stanford-ssi/Aerolotl_AB/aerolotl_ab.kicad_pcb

## KiCad design aerolotl_ab.kicad_pcb (2026-11-02)

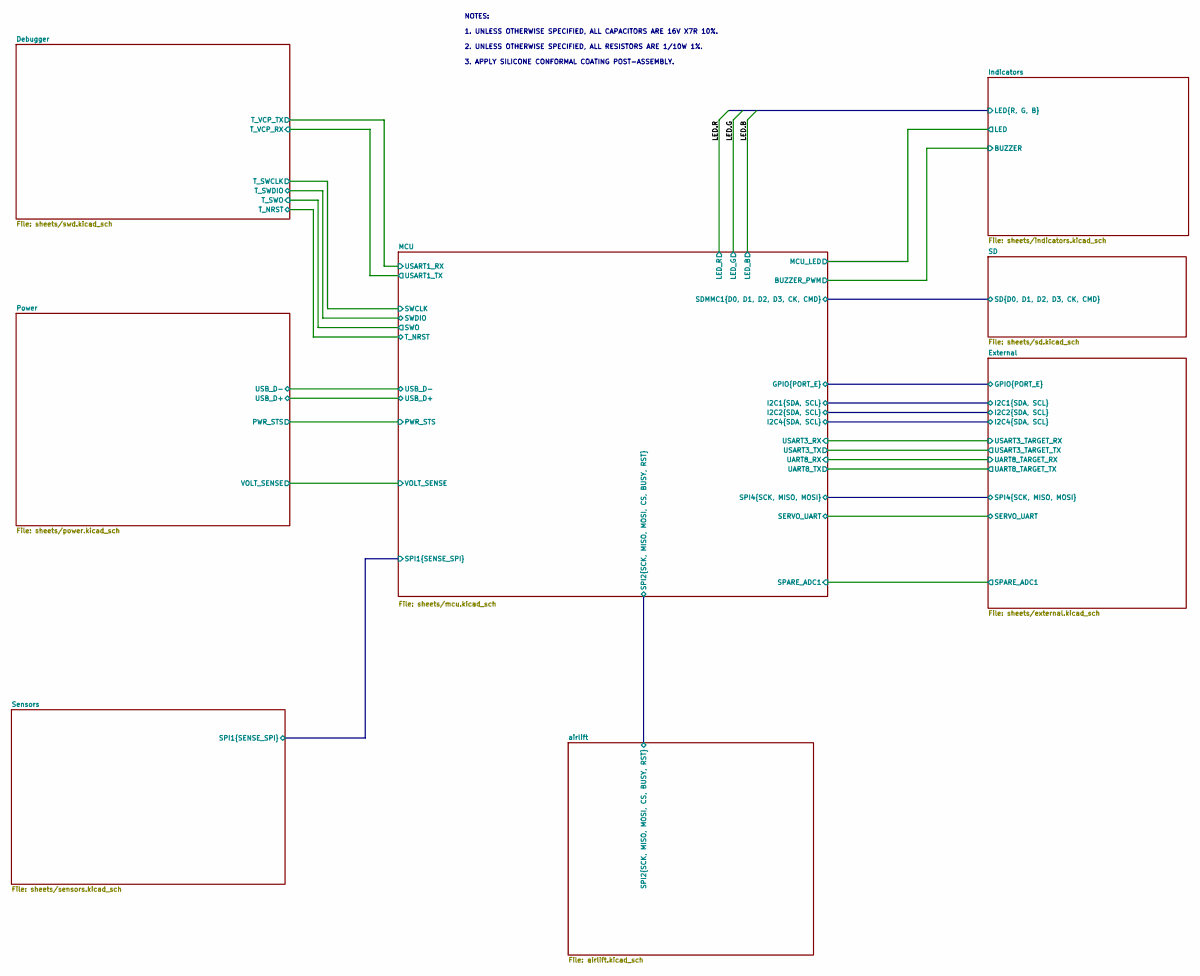
[picture p1: schematic aerolotl_ab.kicad_sch, AEROLOTL AIRBRAKES CONTROLLER]

Notes on the sheet:
NOTES: 1. UNLESS OTHERWISE SPECIFIED, ALL CAPACITORS ARE 16V X7R 10%. 2. UNLESS OTHERWISE SPECIFIED, ALL RESISTORS ARE 1/10W 1%. 3. APPLY SILICONE CONFORMAL COATING POST-ASSEMBLY.

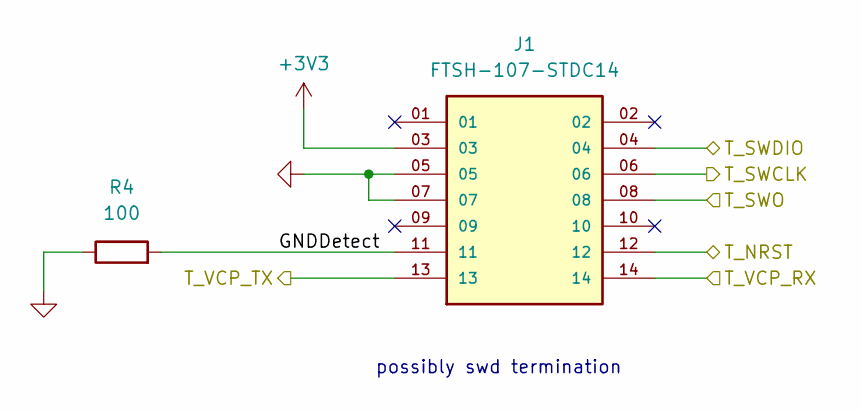
[picture p2: schematic swd.kicad_sch]

Parts:
J1: FTSH-107-STDC14; STDC14_SAMTEC_FTSH-107-01-L-DV-K-A; PARTREV H
R4: 100; R_0402_1005Metric

Connections:
+3V3: J1.03; also elsewhere on the board
/Debugger/GNDDetect: J1.11, R4.2
/Debugger/T_NRST: J1.12; also elsewhere on the board
/Debugger/T_SWCLK: J1.06; also elsewhere on the board
/Debugger/T_SWDIO: J1.04; also elsewhere on the board
/Debugger/T_SWO: J1.08; also elsewhere on the board
/Debugger/T_VCP_RX: J1.14; also elsewhere on the board
/Debugger/T_VCP_TX: J1.13; also elsewhere on the board
GND: J1.05, J1.07, R4.1; also elsewhere on the board

Notes on the sheet:
possibly swd termination

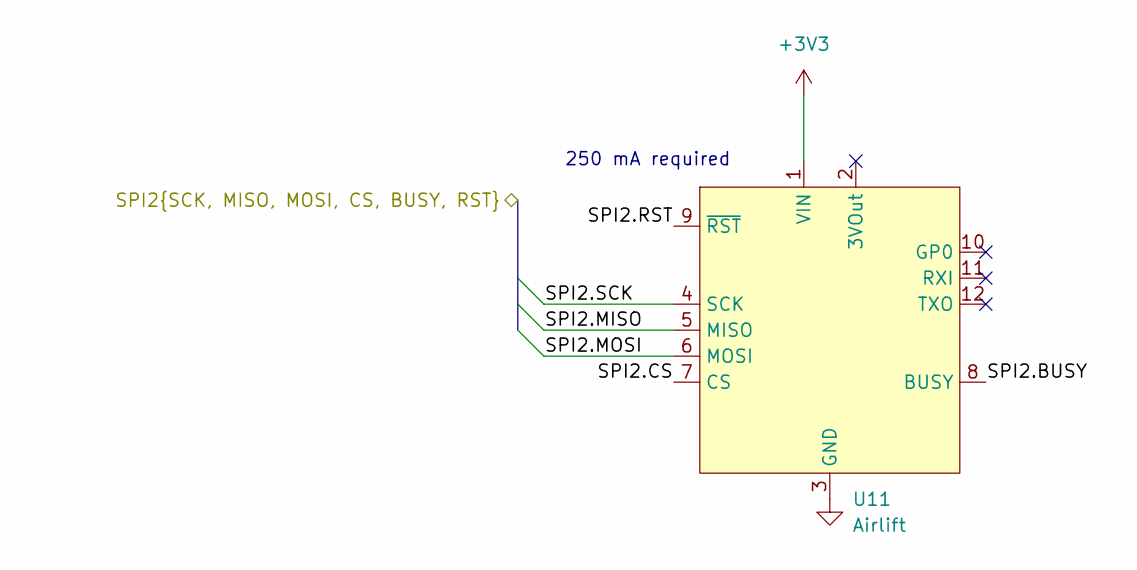
[picture p3: schematic airlift.kicad_sch]

Parts:
U11: Airlift; PinSocket_1x12_P2.54mm_Vertical; Mfr. Part No. 4201

Connections:
+3V3: U11.1 (VIN); also elsewhere on the board
/MCU/SPI2.BUSY: U11.8 (BUSY); also elsewhere on the board
/MCU/SPI2.CS: U11.7 (CS); also elsewhere on the board
/MCU/SPI2.MISO: U11.5 (MISO); also elsewhere on the board
/MCU/SPI2.MOSI: U11.6 (MOSI); also elsewhere on the board
/MCU/SPI2.RST: U11.9 (~RST); also elsewhere on the board
/MCU/SPI2.SCK: U11.4 (SCK); also elsewhere on the board
GND: U11.3 (GND); also elsewhere on the board

Notes on the sheet:
250 mA required

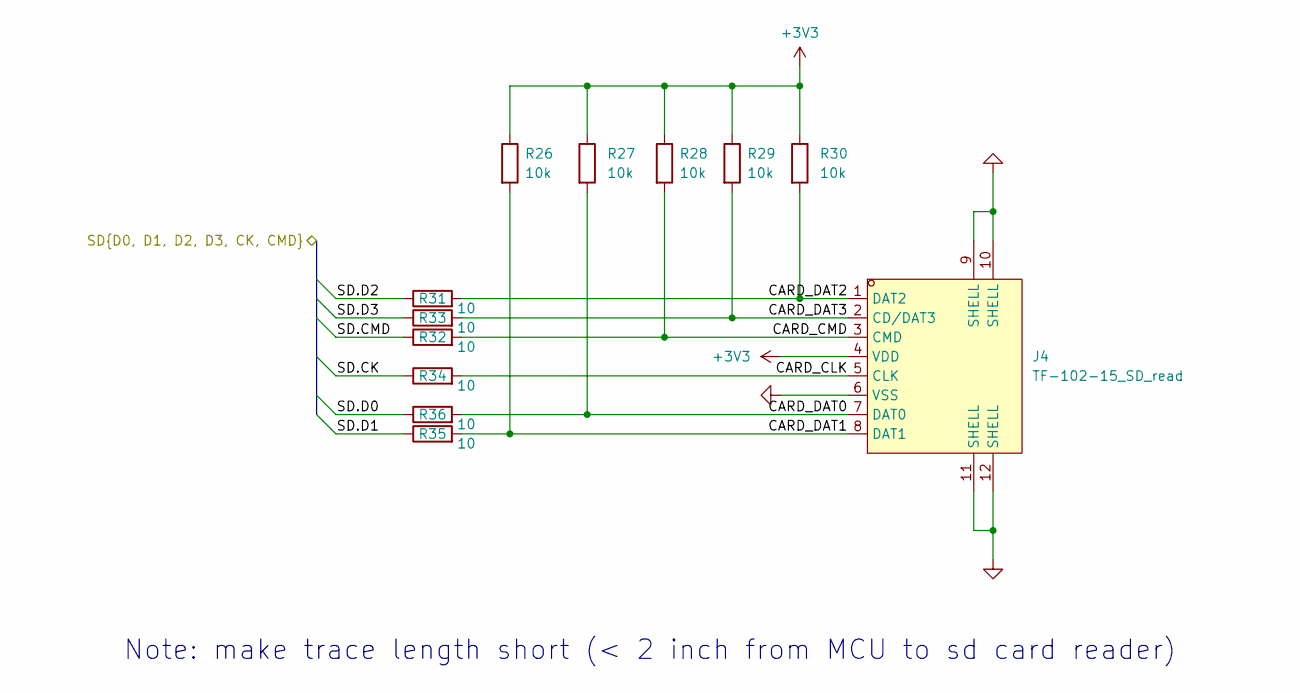
[picture p4: schematic sd.kicad_sch]

Parts:
J4: TF-102-15_SD_read; TF-SMD_TF-102-15; LCSC Part C266609
R26, R27, R28, R29, R30: 10k; R_0402_1005Metric; LCSC Part C25744
R31, R32, R33, R34, R35, R36: 10; R_0402_1005Metric

Connections:
+3V3: J4.4 (VDD), R26.1, R27.1, R28.1, R29.1, R30.1; also elsewhere on the board
/MCU/SDMMC1.CK: R34.1; also elsewhere on the board
/MCU/SDMMC1.CMD: R32.1; also elsewhere on the board
/MCU/SDMMC1.D0: R36.1; also elsewhere on the board
/MCU/SDMMC1.D1: R35.1; also elsewhere on the board
/MCU/SDMMC1.D2: R31.1; also elsewhere on the board
/MCU/SDMMC1.D3: R33.1; also elsewhere on the board
/SD/CARD_CLK: J4.5 (CLK), R34.2
/SD/CARD_CMD: J4.3 (CMD), R28.2, R32.2
/SD/CARD_DAT0: J4.7 (DAT0), R27.2, R36.2
/SD/CARD_DAT1: J4.8 (DAT1), R26.2, R35.2
/SD/CARD_DAT2: J4.1 (DAT2), R30.2, R31.2
/SD/CARD_DAT3: J4.2 (CD/DAT3), R29.2, R33.2
GND: J4.6 (VSS), J4.9 (SHELL), J4.10 (SHELL), J4.11 (SHELL), J4.12 (SHELL); also elsewhere on the board

Notes on the sheet:
Note: make trace length short (< 2 inch from MCU to sd card reader)

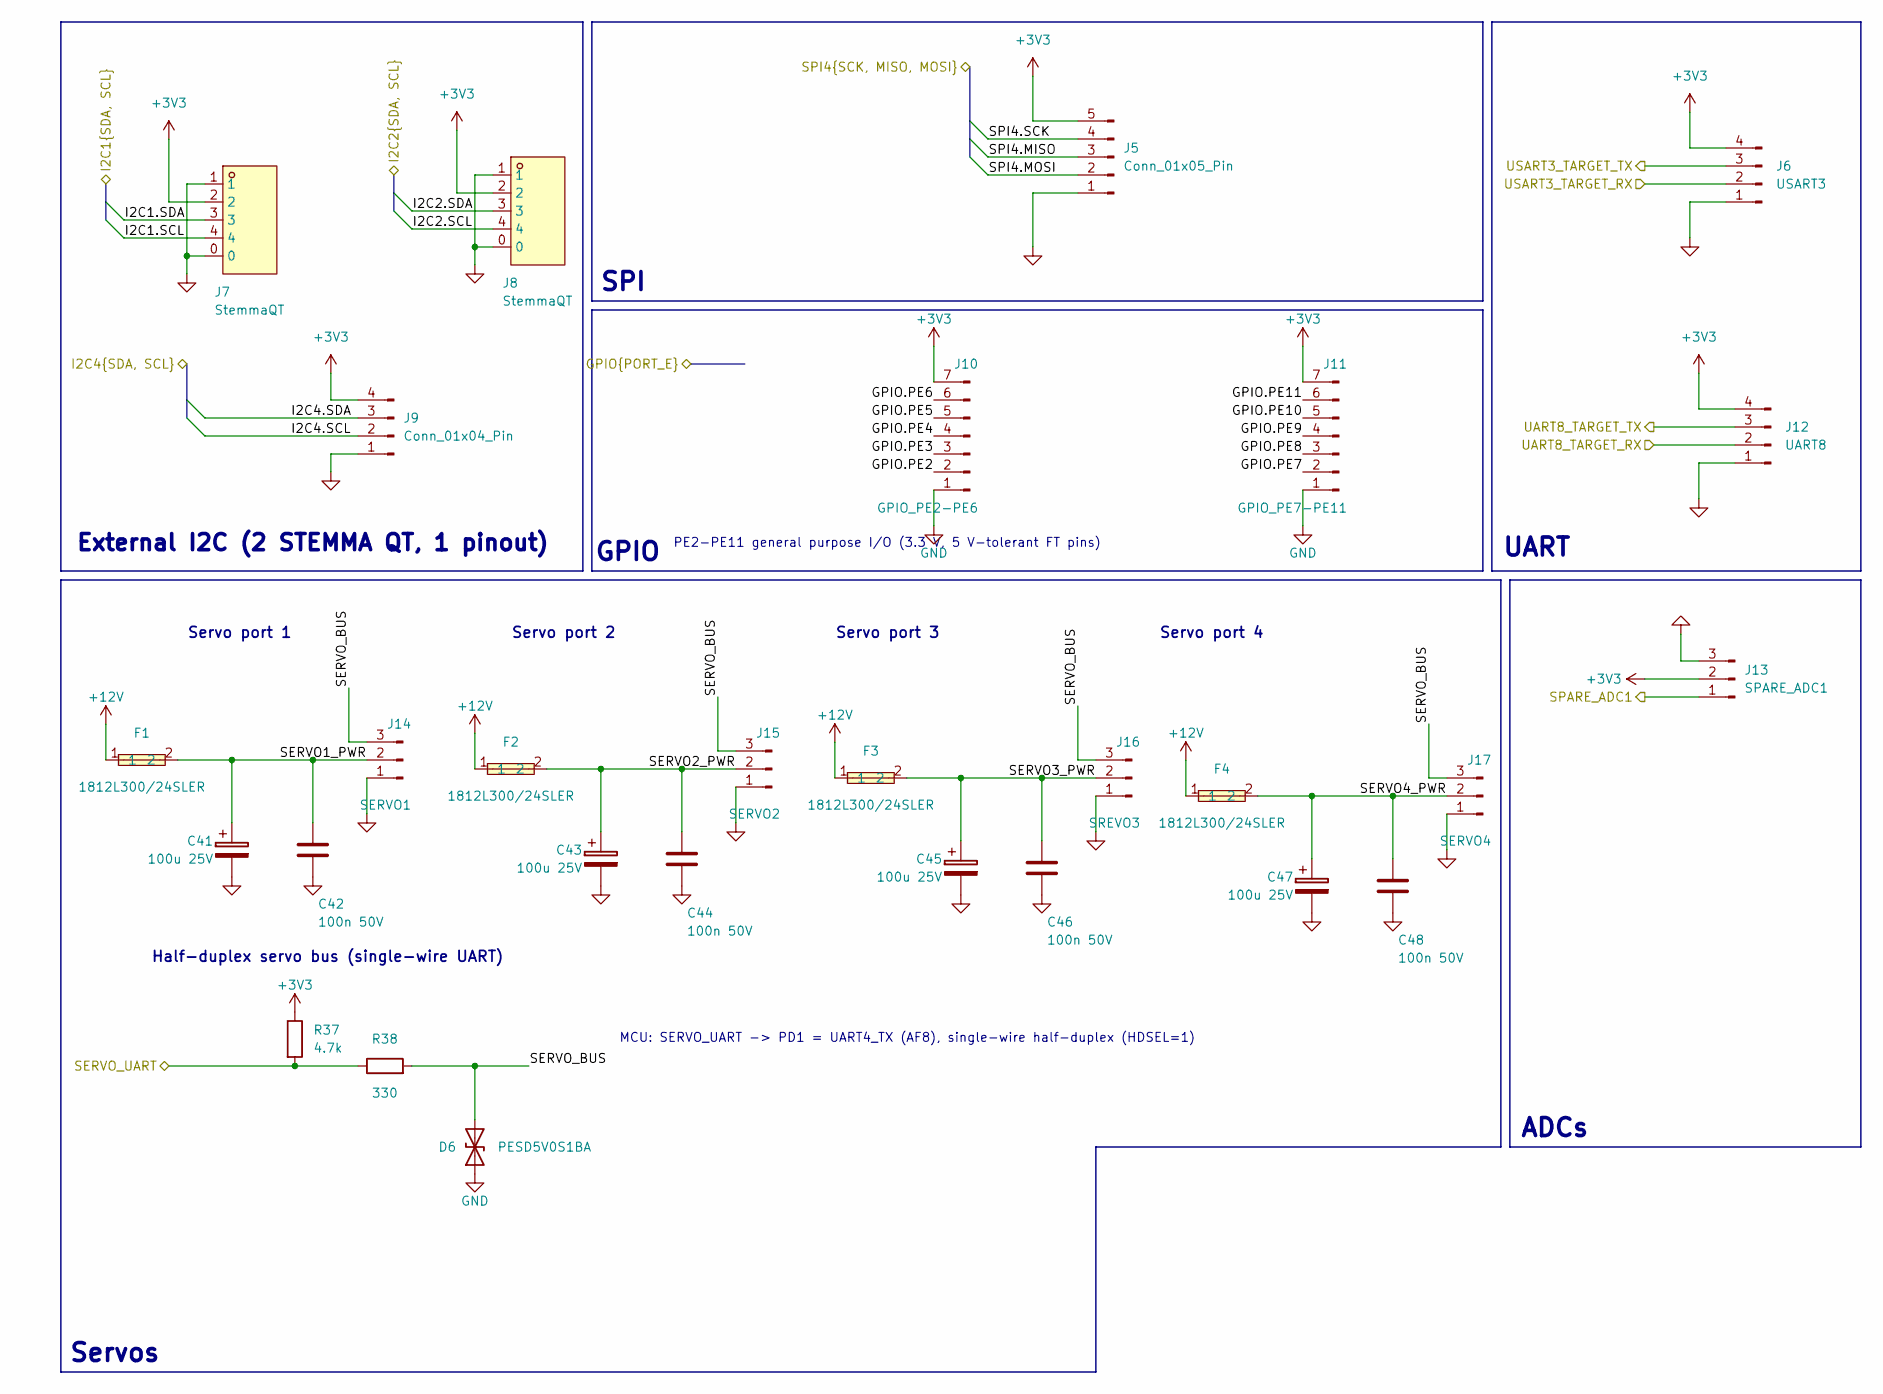
[picture p5: schematic external.kicad_sch]

Parts:
C41, C43, C45, C47: 100u 25V; CP_Elec_6.3x7.7
C42, C44, C46, C48: 100n 50V; C_0603_1608Metric
D6: PESD5V0S1BA; D_SOD-323
F1, F2, F3, F4: 1812L300/24SLER; Fuse_1812_4532Metric; LCSC Part C1512049
J5: Conn_01x05_Pin; JST_GH_BM05B-GHS-TBT_1x05-1MP_P1.25mm_Vertical
J6: USART3; JST_GH_BM04B-GHS-TBT_1x04-1MP_P1.25mm_Vertical
J7, J8: StemmaQT; LCSC Part C160390
J9: Conn_01x04_Pin; JST_GH_BM04B-GHS-TBT_1x04-1MP_P1.25mm_Vertical
J10: GPIO_PE2-PE6; JST_GH_BM07B-GHS-TBT_1x07-1MP_P1.25mm_Vertical; MPN SM07B-GHS-TB
J11: GPIO_PE7-PE11; JST_GH_BM07B-GHS-TBT_1x07-1MP_P1.25mm_Vertical; MPN SM07B-GHS-TB
J12: UART8; JST_GH_BM04B-GHS-TBT_1x04-1MP_P1.25mm_Vertical
J13: SPARE_ADC1; JST_GH_BM03B-GHS-TBT_1x03-1MP_P1.25mm_Vertical
J14: SERVO1; Molex_SPOX_5267-03A_1x03_P2.50mm_Vertical; MPN 5267-03A
J15: SERVO2; Molex_SPOX_5267-03A_1x03_P2.50mm_Vertical; MPN 5267-03A
J16: SREVO3; Molex_SPOX_5267-03A_1x03_P2.50mm_Vertical; MPN 5267-03A
J17: SERVO4; Molex_SPOX_5267-03A_1x03_P2.50mm_Vertical; MPN 5267-03A
R37: 4.7k; R_0402_1005Metric
R38: 330; R_0402_1005Metric

Connections:
+3V3: J5.5, J6.4, J7.2, J8.2, J9.4, J10.7, J11.7, J12.4, J13.2, R37.1; also elsewhere on the board
+12V: F1.1, F2.1, F3.1, F4.1; also elsewhere on the board
/External/GPIO.PE2: J10.2; also elsewhere on the board
/External/GPIO.PE3: J10.3; also elsewhere on the board
/External/GPIO.PE4: J10.4; also elsewhere on the board
/External/GPIO.PE5: J10.5; also elsewhere on the board
/External/GPIO.PE6: J10.6; also elsewhere on the board
/External/GPIO.PE7: J11.2; also elsewhere on the board
/External/GPIO.PE8: J11.3; also elsewhere on the board
/External/GPIO.PE9: J11.4; also elsewhere on the board
/External/GPIO.PE10: J11.5; also elsewhere on the board
/External/GPIO.PE11: J11.6; also elsewhere on the board
/External/I2C1.SCL: J7.4; also elsewhere on the board
/External/I2C1.SDA: J7.3; also elsewhere on the board
/External/I2C2.SCL: J8.4; also elsewhere on the board
/External/I2C2.SDA: J8.3; also elsewhere on the board
/External/I2C4.SCL: J9.2; also elsewhere on the board
/External/I2C4.SDA: J9.3; also elsewhere on the board
/External/SERVO1_PWR: C41.1, C42.1, F1.2, J14.2
/External/SERVO2_PWR: C43.1, C44.1, F2.2, J15.2
/External/SERVO3_PWR: C45.1, C46.1, F3.2, J16.2
/External/SERVO4_PWR: C47.1, C48.1, F4.2, J17.2
/External/SERVO_BUS: D6.2 (A2), J14.3, J15.3, J16.3, J17.3, R38.2
/External/SERVO_UART: R37.2, R38.1; also elsewhere on the board
/External/SPARE_ADC1: J13.1; also elsewhere on the board
/External/SPI4.MISO: J5.3; also elsewhere on the board
/External/SPI4.MOSI: J5.2; also elsewhere on the board
/External/SPI4.SCK: J5.4; also elsewhere on the board
/External/UART8_TARGET_RX: J12.2; also elsewhere on the board
/External/UART8_TARGET_TX: J12.3; also elsewhere on the board
/External/USART3_TARGET_RX: J6.2; also elsewhere on the board
/External/USART3_TARGET_TX: J6.3; also elsewhere on the board
GND: C41.2, C42.2, C43.2, C44.2, C45.2, C46.2, C47.2, C48.2, D6.1 (A1), J5.1, J6.1, J7.0, J7.1, J8.0, J8.1, J9.1, J10.1, J11.1, J12.1, J13.3, J14.1, J15.1, J16.1, J17.1; also elsewhere on the board

Notes on the sheet:
Servo port 1
External I2C (2 STEMMA QT, 1 pinout)
SPI
PE2-PE11 general purpose I/O (3.3 V, 5 V-tolerant FT pins)
Servo port 2
GPIO
Half-duplex servo bus (single-wire UART)
Servo port 4
UART
MCU: SERVO_UART -> PD1 = UART4_TX (AF8), single-wire half-duplex (HDSEL=1)
Servo port 3
Servos
ADCs

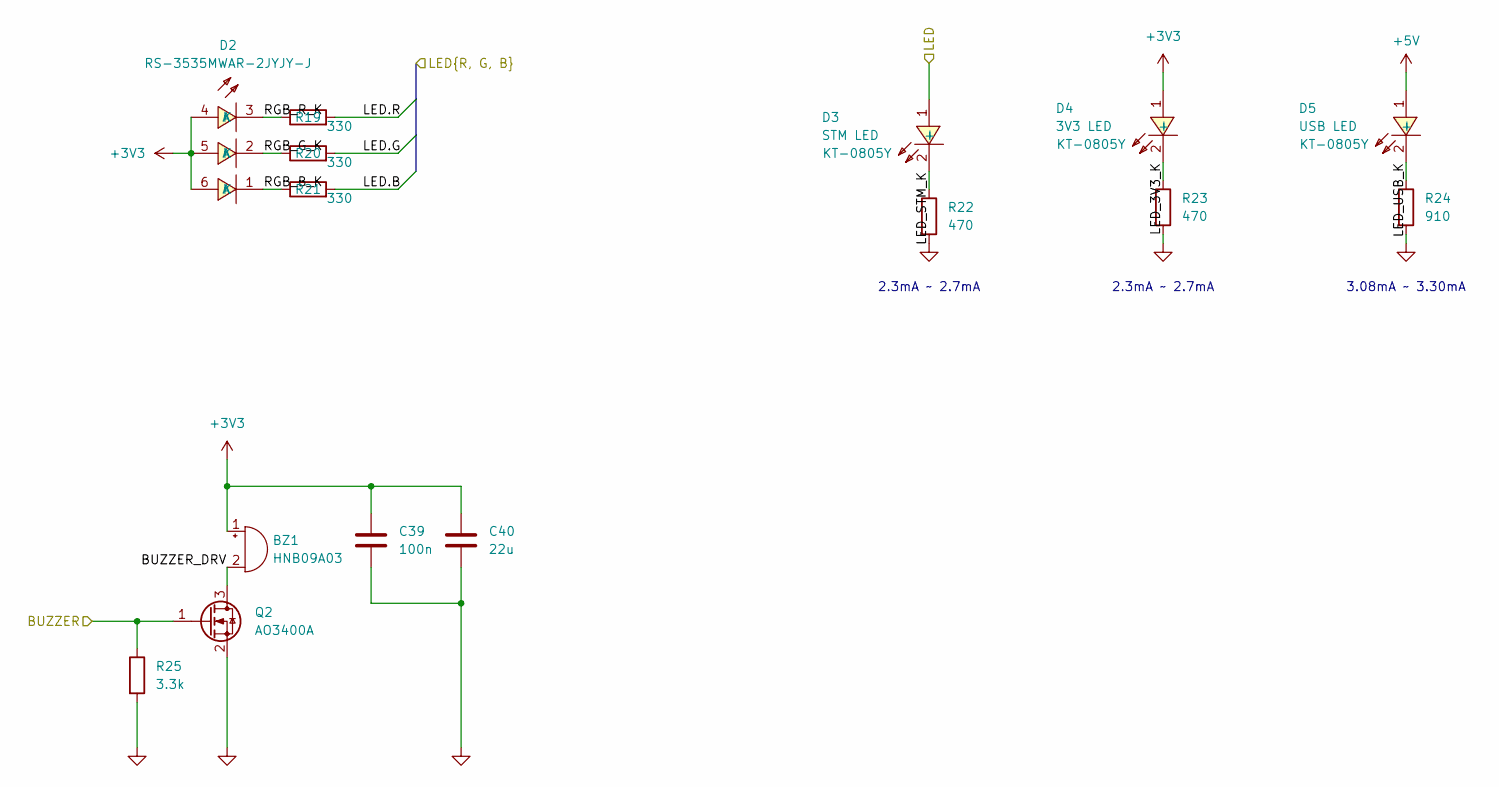
[picture p6: schematic indicators.kicad_sch, AEROLOTL NEW COLLINS FLIGHT COMPUTER]

Parts:
BZ1: HNB09A03; BUZ-TH_BD9.0-P5.00-D0.6-FD
C39: 100n; C_0402_1005Metric; LCSC Part C1525
C40: 22u; C_0805_2012Metric; LCSC Part C45783
D2: RS-3535MWAR-2JYJY-J; LED-SMD_RS-3535MWAR-2JYJY-J; MPN RS-3535MWAR; LCSC Part C110402
D3: STM LED; LED0805-R-RD; LCSC Part C2296
D4: 3V3 LED; LED0805-R-RD; LCSC Part C2296
D5: USB LED; LED0805-R-RD; LCSC Part C2296
Q2: AO3400A; SOT-23
R19, R20, R21: 330; R_0402_1005Metric
R22, R23: 470; R_0402_1005Metric
R24: 910; R_0402_1005Metric
R25: 3.3k; R_0402_1005Metric

Connections:
+3V3: BZ1.1 (+), C39.1, C40.1, D2.4 (A), D2.5 (A), D2.6 (A), D4.1 (+); also elsewhere on the board
+5V: D5.1 (+); also elsewhere on the board
/Indicators/BUZZER: Q2.1 (G), R25.1; also elsewhere on the board
/Indicators/BUZZER_DRV: BZ1.2 (-), Q2.3 (D)
/Indicators/LED: D3.1 (+); also elsewhere on the board
/Indicators/LED.B: R21.2; also elsewhere on the board
/Indicators/LED.G: R20.2; also elsewhere on the board
/Indicators/LED.R: R19.2; also elsewhere on the board
/Indicators/LED_3V3_K: D4.2 (-), R23.1
/Indicators/LED_STM_K: D3.2 (-), R22.1
/Indicators/LED_USB_K: D5.2 (-), R24.1
/Indicators/RGB_B_K: D2.1 (K), R21.1
/Indicators/RGB_G_K: D2.2 (K), R20.1
/Indicators/RGB_R_K: D2.3 (K), R19.1
GND: C39.2, C40.2, Q2.2 (S), R22.2, R23.2, R24.2, R25.2; also elsewhere on the board

Notes on the sheet:
2.3mA ~ 2.7mA
3.08mA ~ 3.30mA

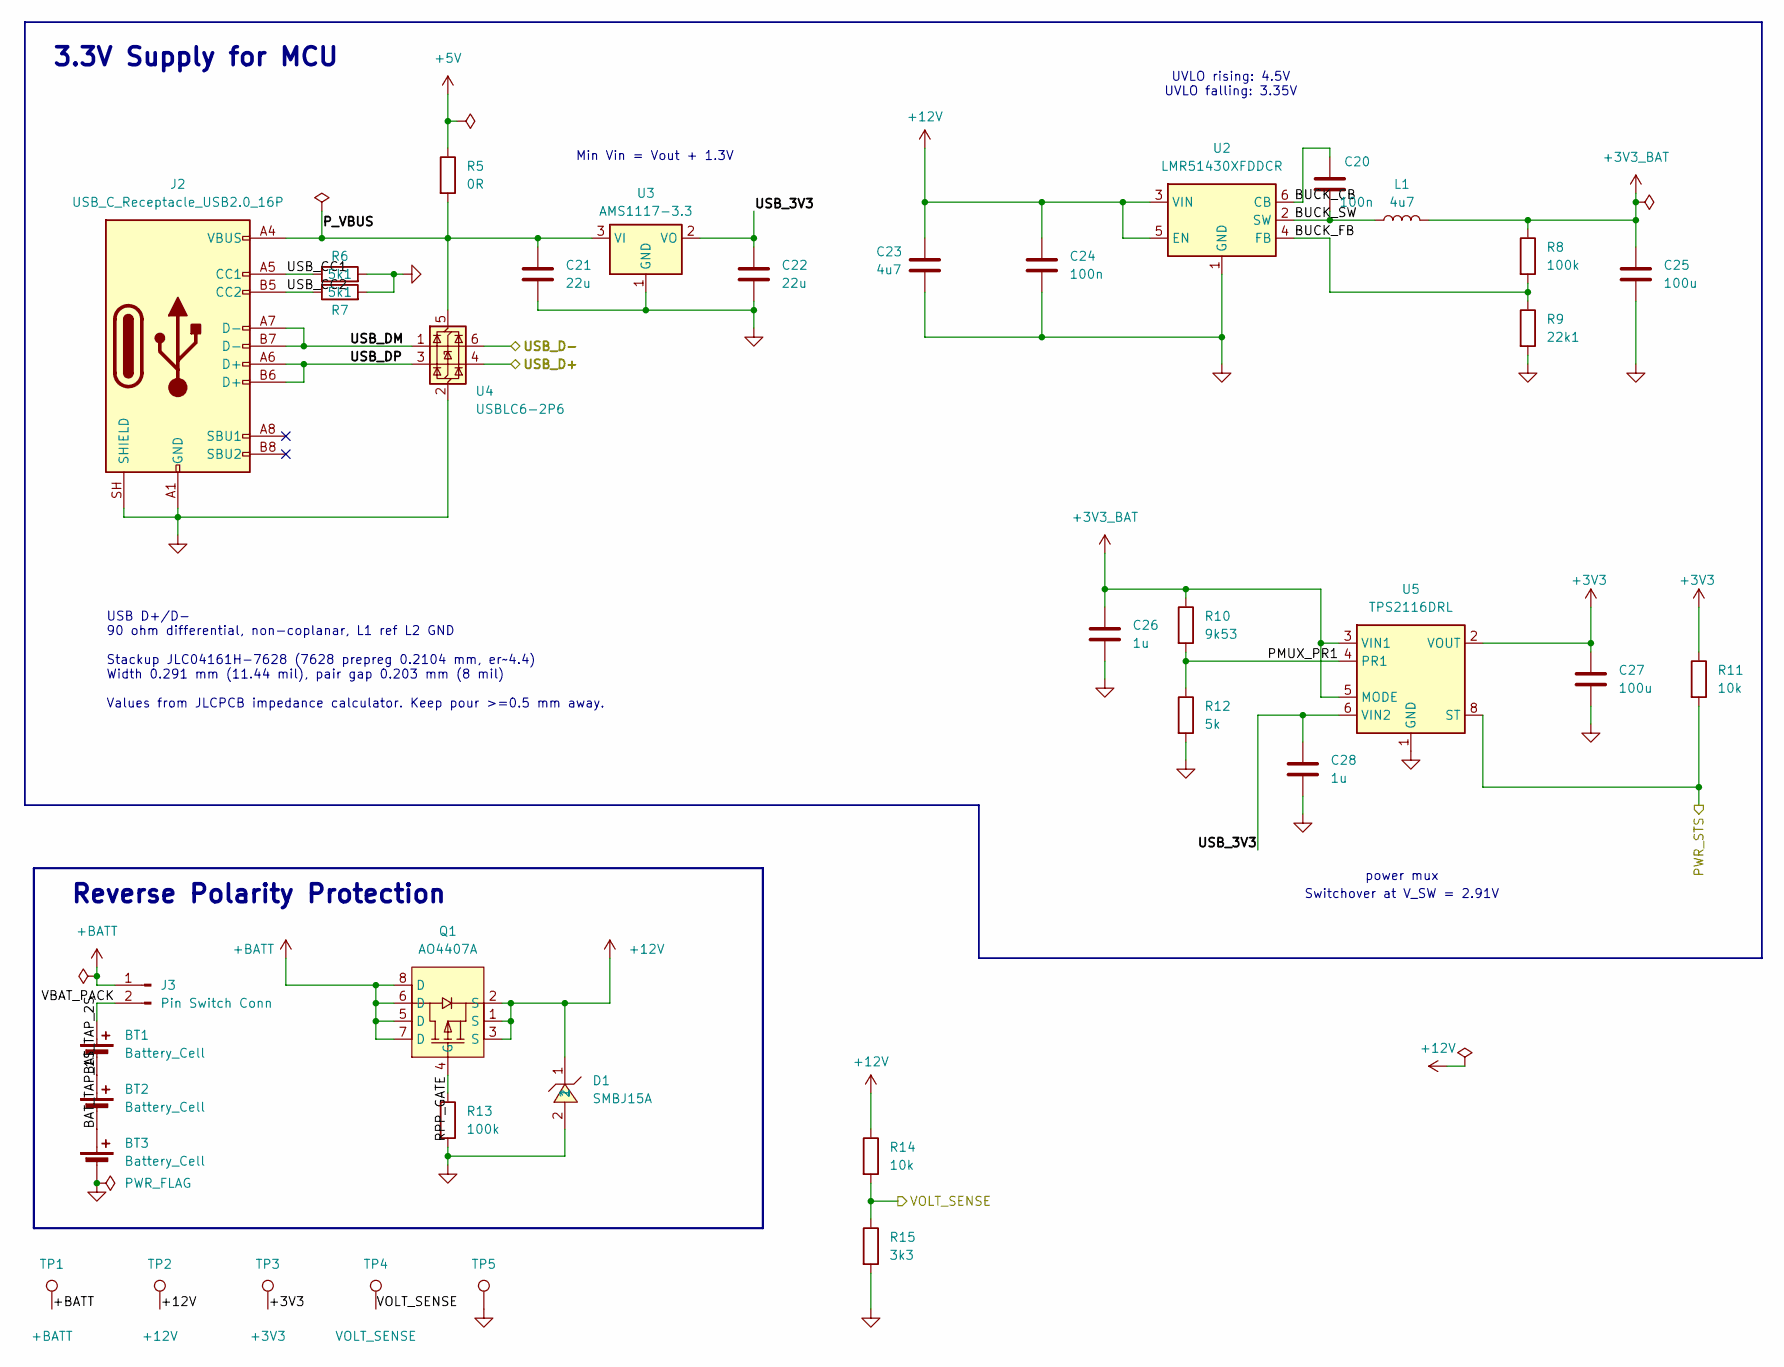
[picture p7: schematic power.kicad_sch]

Parts:
BT1, BT2, BT3: Battery_Cell; BatteryHolder_Keystone_1042_1x18650
C20, C24: 100n; C_0603_1608Metric; LCSC Part C14663
C21, C22: 22u; C_0805_2012Metric; LCSC Part C45783
C23: 4u7; C_0805_2012Metric; Voltage 50V
C25, C27: 100u; C_1206_3216Metric
C26, C28: 1u; C_0402_1005Metric
D1: SMBJ15A; SMB_L4.6-W3.6-LS5.3-RD; LCSC Part C83846
J2: USB_C_Receptacle_USB2.0_16P; USB_C_Receptacle_HRO_TYPE-C-31-M-12
J3: Pin Switch Conn; AMASS_XT30PW-M_1x02_P2.50mm_Horizontal
L1: 4u7; L_Sunlord_SWPA4030S
Q1: AO4407A; SOIC-8_L4.9-W3.9-P1.27-LS6.0-BL; LCSC Part C16072
R5: 0R; R_0603_1608Metric
R6, R7: 5k1; R_0402_1005Metric
R8, R13: 100k; R_0402_1005Metric
R9: 22k1; R_0402_1005Metric
R10: 9k53; R_0402_1005Metric
R11, R14: 10k; R_0402_1005Metric; LCSC Part C25744
R12: 5k; R_0402_1005Metric
R15: 3k3; R_0402_1005Metric
TP1: +BATT; TestPoint_Plated_Hole_D2.0mm
TP2: +12V; TestPoint_Plated_Hole_D2.0mm
TP3: +3V3; TestPoint_Plated_Hole_D2.0mm
TP4: VOLT_SENSE; TestPoint_Plated_Hole_D2.0mm
TP5: GND; TestPoint_Plated_Hole_D2.0mm
U2: LMR51430XFDDCR; SOT-23-6
U3: AMS1117-3.3; SOT-223-3_TabPin2
U4: USBLC6-2P6; SOT-666
U5: TPS2116DRL; SOT-583-8; LCSC C3235557

Connections:
+3V3: C27.1, R11.1, TP3.1 (1_1), U5.2 (VOUT), U5.7 (VOUT); also elsewhere on the board
+3V3_BAT: C25.1, C26.1, L1.2, R8.1, R10.1, U5.3 (VIN1), U5.5 (MODE)
+5V: R5.1; also elsewhere on the board
+12V: C23.1, C24.1, D1.1, Q1.1 (S), Q1.2 (S), Q1.3 (S), R14.1, TP2.1 (1_1), U2.3 (VIN), U2.5 (EN); also elsewhere on the board
+BATT: J3.1, Q1.5 (D), Q1.6 (D), Q1.7 (D), Q1.8 (D), TP1.1 (1_1)
/MCU/PWR_STS: R11.2, U5.8 (ST); also elsewhere on the board
/MCU/USB_D+: U4.4 (I/O2); also elsewhere on the board
/MCU/USB_D-: U4.6 (I/O1); also elsewhere on the board
/Power/BAT_TAP_1S: BT2.2 (-), BT3.1 (+)
/Power/BAT_TAP_2S: BT1.2 (-), BT2.1 (+)
/Power/BUCK_CB: C20.1, U2.6 (CB)
/Power/BUCK_FB: R8.2, R9.1, U2.4 (FB)
/Power/BUCK_SW: C20.2, L1.1, U2.2 (SW)
/Power/PMUX_PR1: R10.2, R12.1, U5.4 (PR1)
/Power/P_VBUS: C21.1, J2.A4 (VBUS), J2.A9 (VBUS), J2.B4 (VBUS), J2.B9 (VBUS), R5.2, U3.3 (VI), U4.5 (VBUS)
/Power/RPP_GATE: Q1.4 (G), R13.1
/Power/USB_3V3: C22.1, C28.1, U3.2 (VO), U5.6 (VIN2)
/Power/USB_CC1: J2.A5 (CC1), R6.1
/Power/USB_CC2: J2.B5 (CC2), R7.1
/Power/USB_DM: J2.A7 (D-), J2.B7 (D-), U4.1 (I/O1)
/Power/USB_DP: J2.A6 (D+), J2.B6 (D+), U4.3 (I/O2)
/Power/VBAT_PACK: BT1.1 (+), J3.2
/Power/VOLT_SENSE: R14.2, R15.1, TP4.1 (1_1); also elsewhere on the board
GND: BT3.2 (-), C21.2, C22.2, C23.2, C24.2, C25.2, C26.2, C27.2, C28.2, D1.2, J2.A1 (GND), J2.A12 (GND), J2.B1 (GND), J2.B12 (GND), J2.SH (SHIELD), R6.2, R7.2, R9.2, R12.2, R13.2, R15.2, TP5.1 (1_1), U2.1 (GND), U3.1 (GND), U4.2 (GND), U5.1 (GND); also elsewhere on the board

Notes on the sheet:
3.3V Supply for MCU
power mux
Switchover at V_SW = 2.91V
Reverse Polarity Protection
UVLO rising: 4.5V UVLO falling: 3.35V
Min Vin = Vout + 1.3V
USB D+/D- 90 ohm differential, non-coplanar, L1 ref L2 GND Stackup JLC04161H-7628 (7628 prepreg 0.2104 mm, er~4.4) Width 0.291 mm (11.44 mil), pair gap 0.203 mm (8 mil) Values from JLCPCB impedance calculator. Keep pour >=0.5 mm away.

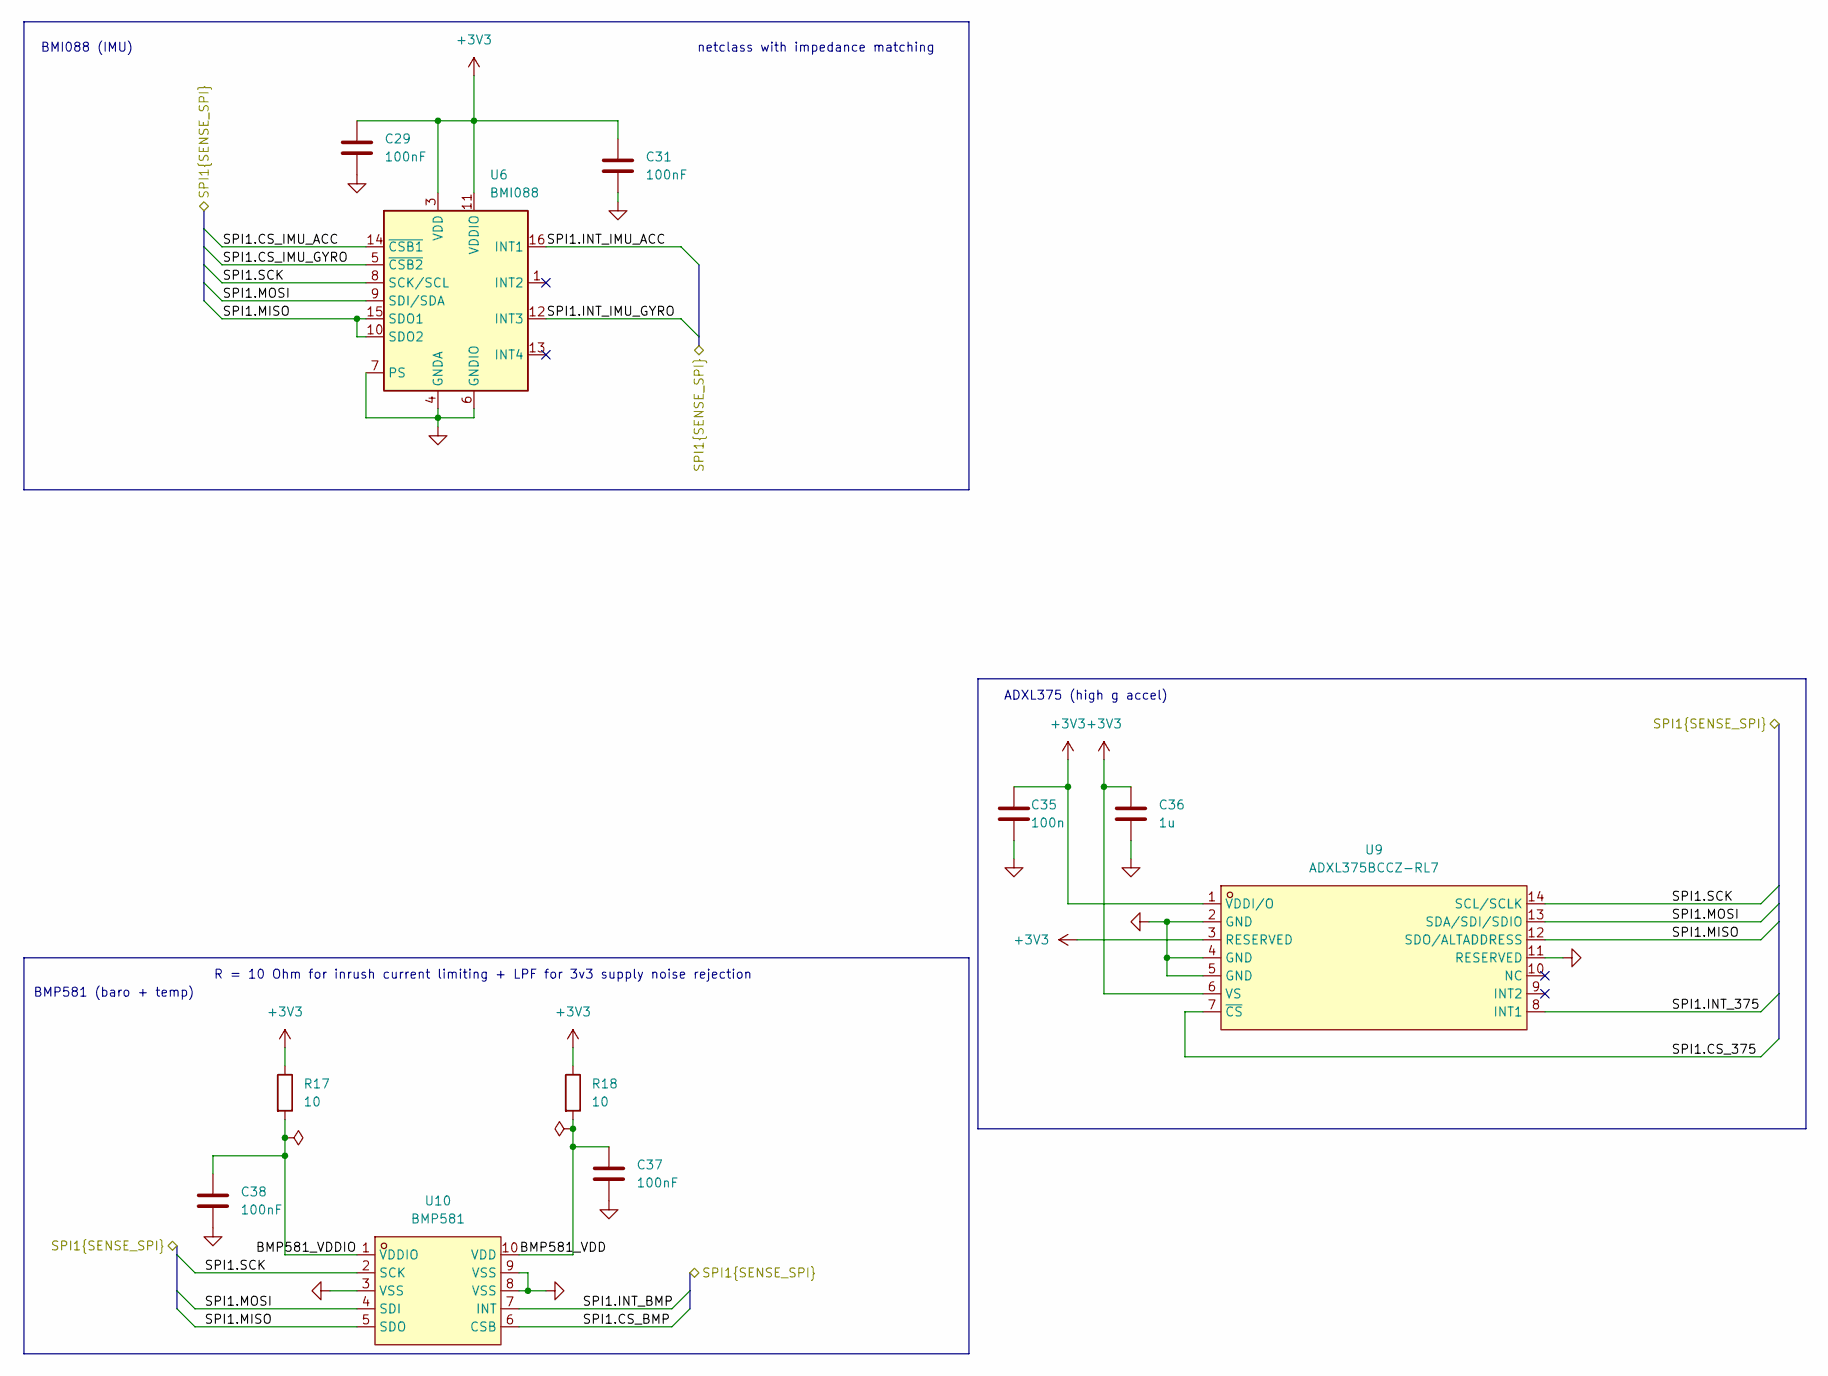
[picture p8: schematic sensors.kicad_sch]

Parts:
C29, C31, C37, C38: 100nF; C_0402_1005Metric; LCSC Part C1525
C35: 100n; C_0402_1005Metric; LCSC Part C1525
C36: 1u; C_0402_1005Metric
R17, R18: 10; R_0402_1005Metric
U6: BMI088; Bosch_LGA-16_4.5x3mm_P0.5mm_LayoutBorder7x1y_ClockwisePinNu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
U9: ADXL375BCCZ-RL7; ADXL375_LGA-14_L5.0-W3.0-P0.80-BL; LCSC Part C481898
U10: BMP581; LGA-10_L2.0-W2.0-P0.50-TL_BMP581; LCSC Part C5362283

Connections:
+3V3: C29.1, C31.1, C35.1, C36.1, R17.1, R18.1, U6.3 (VDD), U6.11 (VDDIO), U9.1 (VDDI/O), U9.3 (RESERVED), U9.6 (VS); also elsewhere on the board
/MCU/SPI1.CS_375: U9.7 (~CS); also elsewhere on the board
/MCU/SPI1.CS_BMP: U10.6 (CSB); also elsewhere on the board
/MCU/SPI1.CS_IMU_ACC: U6.14 (~CSB1); also elsewhere on the board
/MCU/SPI1.CS_IMU_GYRO: U6.5 (~CSB2); also elsewhere on the board
/MCU/SPI1.INT_375: U9.8 (INT1); also elsewhere on the board
/MCU/SPI1.INT_BMP: U10.7 (INT); also elsewhere on the board
/MCU/SPI1.INT_IMU_ACC: U6.16 (INT1); also elsewhere on the board
/MCU/SPI1.INT_IMU_GYRO: U6.12 (INT3); also elsewhere on the board
/MCU/SPI1.MISO: U6.10 (SDO2), U6.15 (SDO1), U9.12 (SDO/ALTADDRESS), U10.5 (SDO); also elsewhere on the board
/MCU/SPI1.MOSI: U6.9 (SDI/SDA), U9.13 (SDA/SDI/SDIO), U10.4 (SDI); also elsewhere on the board
/MCU/SPI1.SCK: U6.8 (SCK/SCL), U9.14 (SCL/SCLK), U10.2 (SCK); also elsewhere on the board
/Sensors/BMP581_VDD: C37.1, R18.2, U10.10 (VDD)
/Sensors/BMP581_VDDIO: C38.1, R17.2, U10.1 (VDDIO)
GND: C29.2, C31.2, C35.2, C36.2, C37.2, C38.2, U6.2 (GNDA), U6.4 (GNDA), U6.6 (GNDIO), U6.7 (PS), U9.2 (GND), U9.4 (GND), U9.5 (GND), U9.11 (RESERVED), U10.3 (VSS), U10.8 (VSS), U10.9 (VSS); also elsewhere on the board

Notes on the sheet:
ADXL375 (high g accel)
R = 10 Ohm for inrush current limiting + LPF for 3v3 supply noise rejection
BMI088 (IMU)
netclass with impedance matching
BMP581 (baro + temp)
