stanford-ssi/Aerolotl_AB/aerolotl_ab.kicad_pcb

## KiCad design aerolotl_ab.kicad_pcb (continued)

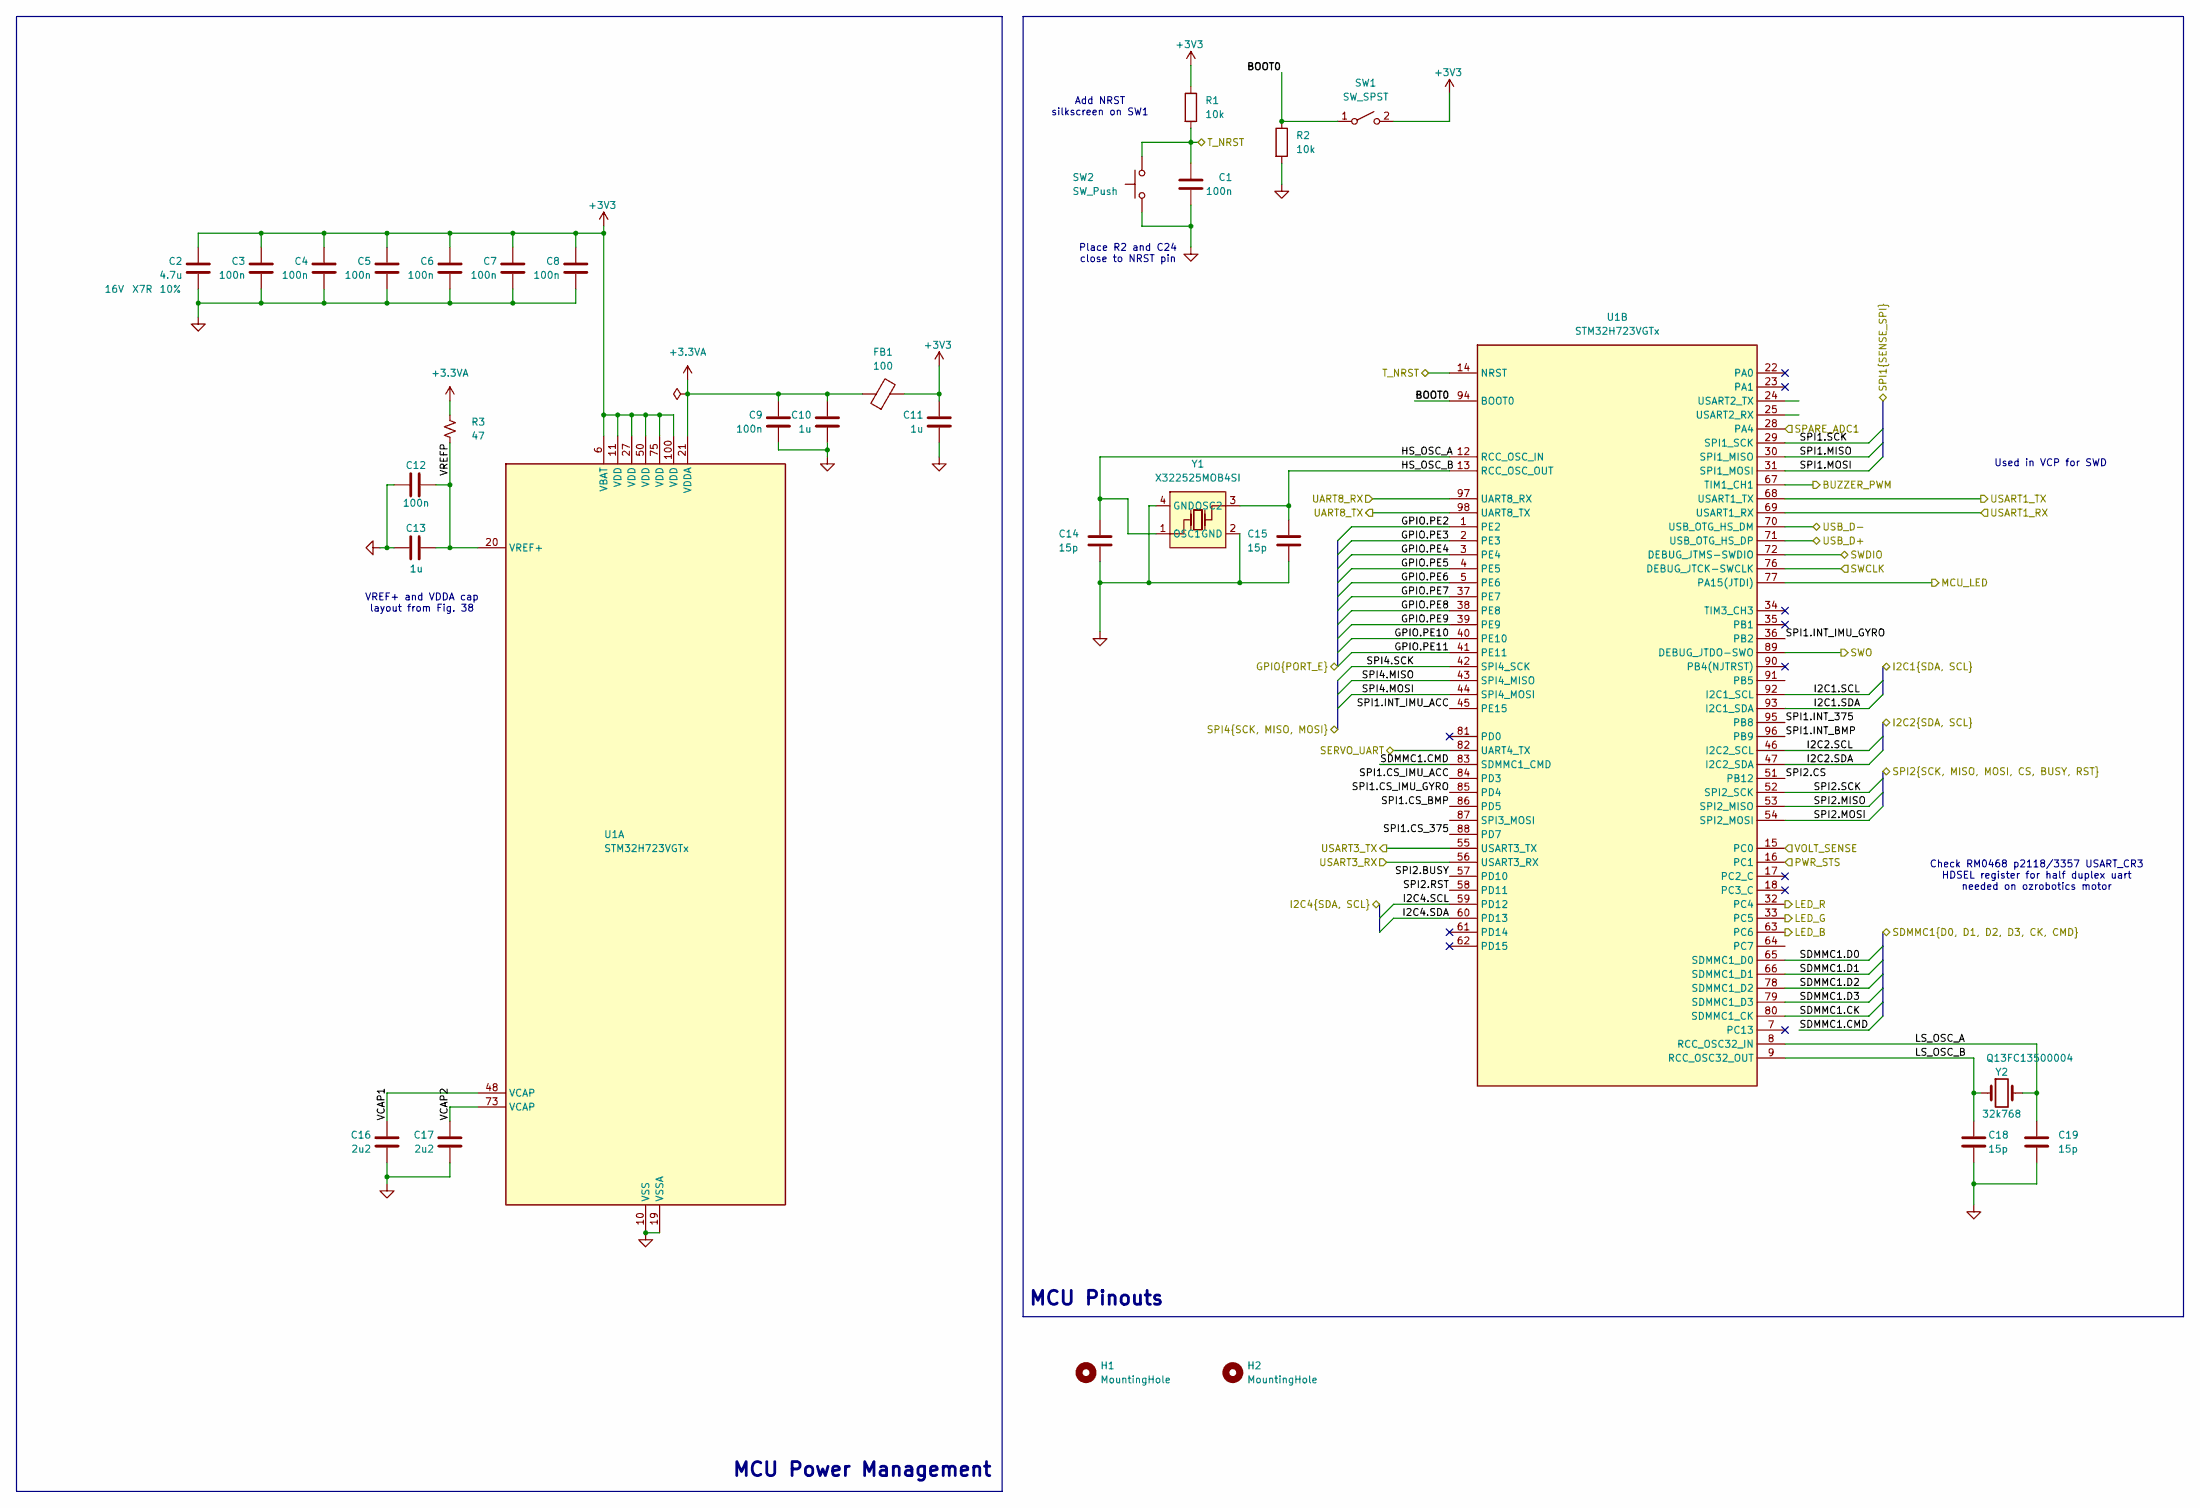
[picture p9: schematic mcu.kicad_sch, AEROLOTL NEW COLLINS FLIGHT COMPUTER]

Parts:
C1: 100n; C_0603_1608Metric
C2: 4.7u; C_0805_2012Metric; Tolerance 10%; Voltage 16V
C3, C4, C5, C6, C7, C8, C9, C12: 100n; C_0402_1005Metric
C10, C11, C13: 1u; C_0603_1608Metric
C14, C15, C18, C19: 15p; C_0402_1005Metric
C16, C17: 2u2; C_0402_1005Metric
FB1: 100; L_0805_2012Metric
H1, H2: MountingHole; MountingHole_6.4mm_M6_ISO7380
R1, R2: 10k; R_0603_1608Metric
R3: 47; R_0402_1005Metric
SW1: SW_SPST; SW_SPST_TL3342
SW2: SW_Push; SW_SPST_TL3342
U1: STM32H723VGTx; LQFP-100_14x14mm_P0.5mm
Y1: X322525MOB4SI; CRYSTAL-SMD_4P-L3.2-W2.5-BL; LCSC Part C9006
Y2: 32k768; Crystal_SMD_3215-2Pin_3.2x1.5mm; mfr. part no. Q13FC13500004

Connections:
+3.3VA: C9.1, C10.1, FB1.1, R3.1, U1.21 (VDDA)
+3V3: C2.1, C3.1, C4.1, C5.1, C6.1, C7.1, C8.1, C11.1, FB1.2, R1.1, SW1.2 (B), U1.6 (VBAT), U1.11 (VDD), U1.27 (VDD), U1.50 (VDD), U1.75 (VDD), U1.100 (VDD); also elsewhere on the board
/Debugger/T_NRST: C1.1, R1.2, SW2.2, U1.14 (NRST); also elsewhere on the board
/Debugger/T_SWCLK: U1.76 (DEBUG_JTCK-SWCLK); also elsewhere on the board
/Debugger/T_SWDIO: U1.72 (DEBUG_JTMS-SWDIO); also elsewhere on the board
/Debugger/T_SWO: U1.89 (DEBUG_JTDO-SWO); also elsewhere on the board
/Debugger/T_VCP_RX: U1.68 (USART1_TX); also elsewhere on the board
/Debugger/T_VCP_TX: U1.69 (USART1_RX); also elsewhere on the board
/External/GPIO.PE2: U1.1 (PE2); also elsewhere on the board
/External/GPIO.PE3: U1.2 (PE3); also elsewhere on the board
/External/GPIO.PE4: U1.3 (PE4); also elsewhere on the board
/External/GPIO.PE5: U1.4 (PE5); also elsewhere on the board
/External/GPIO.PE6: U1.5 (PE6); also elsewhere on the board
/External/GPIO.PE7: U1.37 (PE7); also elsewhere on the board
/External/GPIO.PE8: U1.38 (PE8); also elsewhere on the board
/External/GPIO.PE9: U1.39 (PE9); also elsewhere on the board
/External/GPIO.PE10: U1.40 (PE10); also elsewhere on the board
/External/GPIO.PE11: U1.41 (PE11); also elsewhere on the board
/External/I2C1.SCL: U1.92 (I2C1_SCL); also elsewhere on the board
/External/I2C1.SDA: U1.93 (I2C1_SDA); also elsewhere on the board
/External/I2C2.SCL: U1.46 (I2C2_SCL); also elsewhere on the board
/External/I2C2.SDA: U1.47 (I2C2_SDA); also elsewhere on the board
/External/I2C4.SCL: U1.59 (PD12); also elsewhere on the board
/External/I2C4.SDA: U1.60 (PD13); also elsewhere on the board
/External/SERVO_UART: U1.82 (UART4_TX); also elsewhere on the board
/External/SPARE_ADC1: U1.28 (PA4); also elsewhere on the board
/External/SPI4.MISO: U1.43 (SPI4_MISO); also elsewhere on the board
/External/SPI4.MOSI: U1.44 (SPI4_MOSI); also elsewhere on the board
/External/SPI4.SCK: U1.42 (SPI4_SCK); also elsewhere on the board
/External/UART8_TARGET_RX: U1.97 (UART8_RX); also elsewhere on the board
/External/UART8_TARGET_TX: U1.98 (UART8_TX); also elsewhere on the board
/External/USART3_TARGET_RX: U1.56 (USART3_RX); also elsewhere on the board
/External/USART3_TARGET_TX: U1.55 (USART3_TX); also elsewhere on the board
/Indicators/BUZZER: U1.67 (TIM1_CH1); also elsewhere on the board
/Indicators/LED: U1.77 (PA15(JTDI)); also elsewhere on the board
/Indicators/LED.B: U1.63 (PC6); also elsewhere on the board
/Indicators/LED.G: U1.33 (PC5); also elsewhere on the board
/Indicators/LED.R: U1.32 (PC4); also elsewhere on the board
/MCU/BOOT0: R2.1, SW1.1 (A), U1.94 (BOOT0)
/MCU/HS_OSC_A: C14.1, U1.12 (RCC_OSC_IN), Y1.1 (OSC1)
/MCU/HS_OSC_B: C15.1, U1.13 (RCC_OSC_OUT), Y1.3 (OSC2)
/MCU/LS_OSC_A: C19.1, U1.8 (RCC_OSC32_IN), Y2.2
/MCU/LS_OSC_B: C18.1, U1.9 (RCC_OSC32_OUT), Y2.1
/MCU/PWR_STS: U1.16 (PC1); also elsewhere on the board
/MCU/SDMMC1.CK: U1.80 (SDMMC1_CK); also elsewhere on the board
/MCU/SDMMC1.CMD: U1.83 (SDMMC1_CMD); also elsewhere on the board
/MCU/SDMMC1.D0: U1.65 (SDMMC1_D0); also elsewhere on the board
/MCU/SDMMC1.D1: U1.66 (SDMMC1_D1); also elsewhere on the board
/MCU/SDMMC1.D2: U1.78 (SDMMC1_D2); also elsewhere on the board
/MCU/SDMMC1.D3: U1.79 (SDMMC1_D3); also elsewhere on the board
/MCU/SPI1.CS_375: U1.88 (PD7); also elsewhere on the board
/MCU/SPI1.CS_BMP: U1.86 (PD5); also elsewhere on the board
/MCU/SPI1.CS_IMU_ACC: U1.84 (PD3); also elsewhere on the board
/MCU/SPI1.CS_IMU_GYRO: U1.85 (PD4); also elsewhere on the board
/MCU/SPI1.INT_375: U1.95 (PB8); also elsewhere on the board
/MCU/SPI1.INT_BMP: U1.96 (PB9); also elsewhere on the board
/MCU/SPI1.INT_IMU_ACC: U1.45 (PE15); also elsewhere on the board
/MCU/SPI1.INT_IMU_GYRO: U1.36 (PB2); also elsewhere on the board
/MCU/SPI1.MISO: U1.30 (SPI1_MISO); also elsewhere on the board
/MCU/SPI1.MOSI: U1.31 (SPI1_MOSI); also elsewhere on the board
/MCU/SPI1.SCK: U1.29 (SPI1_SCK); also elsewhere on the board
/MCU/SPI2.BUSY: U1.57 (PD10); also elsewhere on the board
/MCU/SPI2.CS: U1.51 (PB12); also elsewhere on the board
/MCU/SPI2.MISO: U1.53 (SPI2_MISO); also elsewhere on the board
/MCU/SPI2.MOSI: U1.54 (SPI2_MOSI); also elsewhere on the board
/MCU/SPI2.RST: U1.58 (PD11); also elsewhere on the board
/MCU/SPI2.SCK: U1.52 (SPI2_SCK); also elsewhere on the board
/MCU/USB_D+: U1.71 (USB_OTG_HS_DP); also elsewhere on the board
/MCU/USB_D-: U1.70 (USB_OTG_HS_DM); also elsewhere on the board
/MCU/VCAP1: C16.1, U1.48 (VCAP)
/MCU/VCAP2: C17.1, U1.73 (VCAP)
/MCU/VREFP: C12.1, C13.1, R3.2, U1.20 (VREF+)
/Power/VOLT_SENSE: U1.15 (PC0); also elsewhere on the board
GND: C1.2, C2.2, C3.2, C4.2, C5.2, C6.2, C7.2, C8.2, C9.2, C10.2, C11.2, C12.2, C13.2, C14.2, C15.2, C16.2, C17.2, C18.2, C19.2, R2.2, SW2.1, U1.10 (VSS), U1.19 (VSSA), U1.26 (VSS), U1.49 (VSS), U1.74 (VSS), U1.99 (VSS), Y1.2 (GND), Y1.4 (GND); also elsewhere on the board

Notes on the sheet:
Used in VCP for SWD
MCU Power Management
Place R2 and C24 close to NRST pin
VREF+ and VDDA cap layout from Fig. 38
Check RM0468 p2118/3357 USART_CR3 HDSEL register for half duplex uart needed on ozrobotics motor
Add NRST silkscreen on SW1
MCU Pinouts

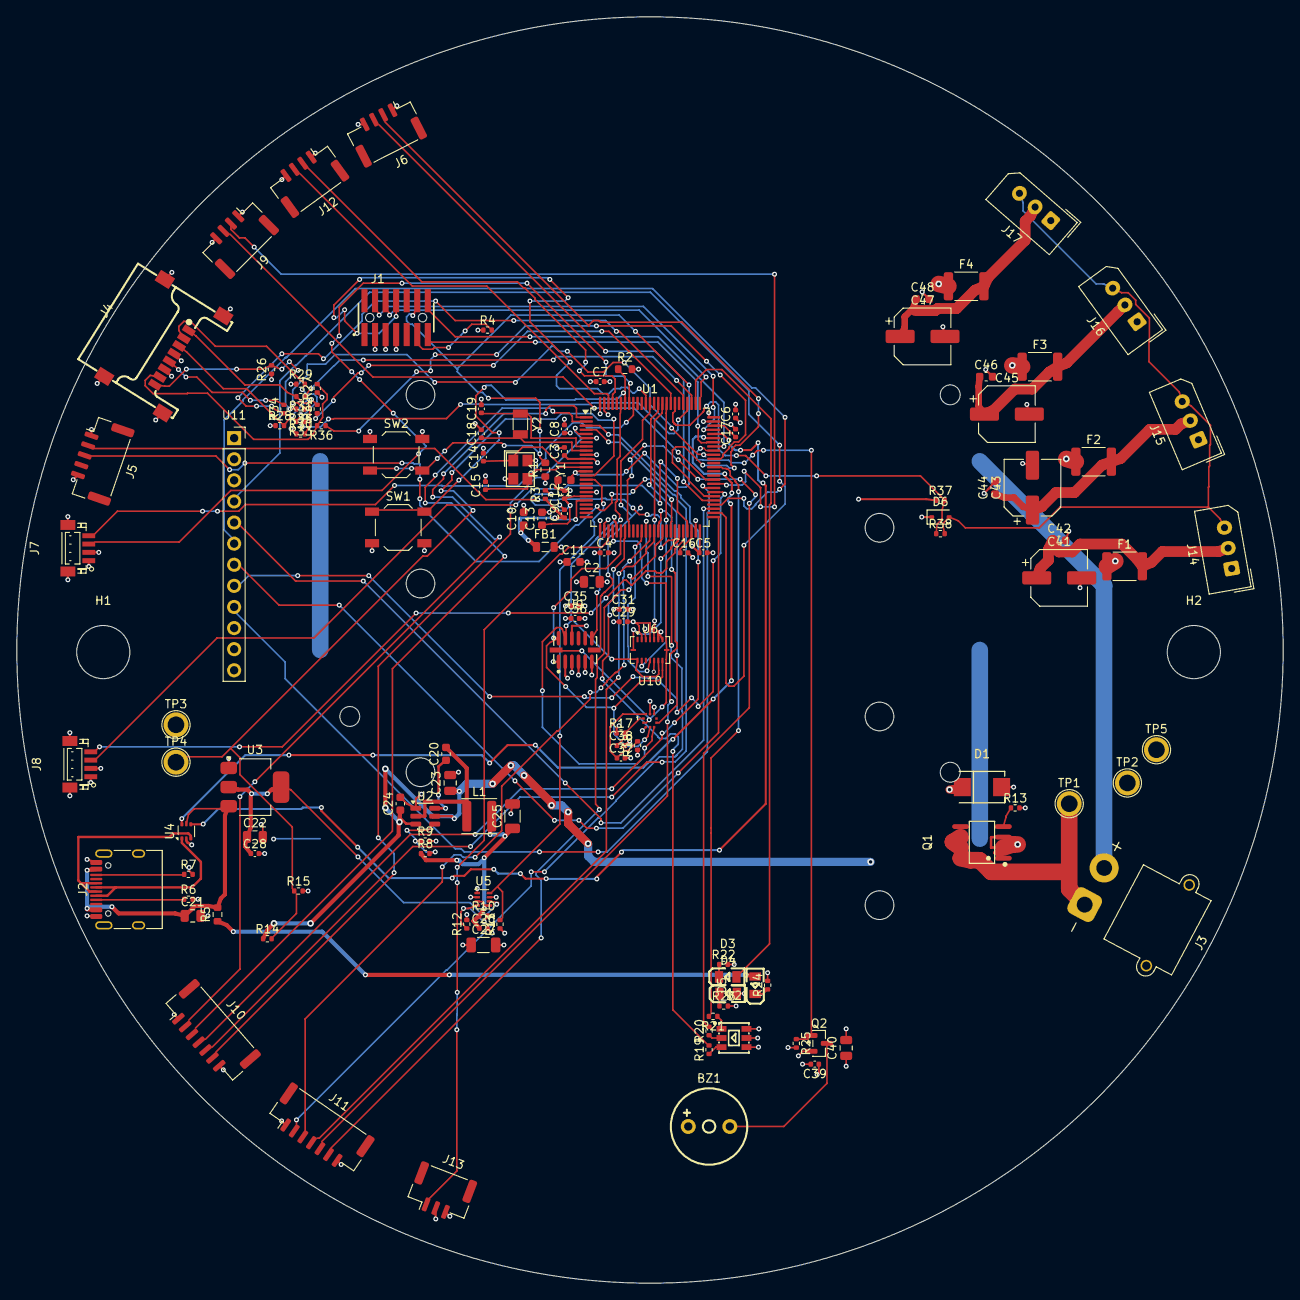
[picture p10: board aerolotl_ab.kicad_pcb from above]

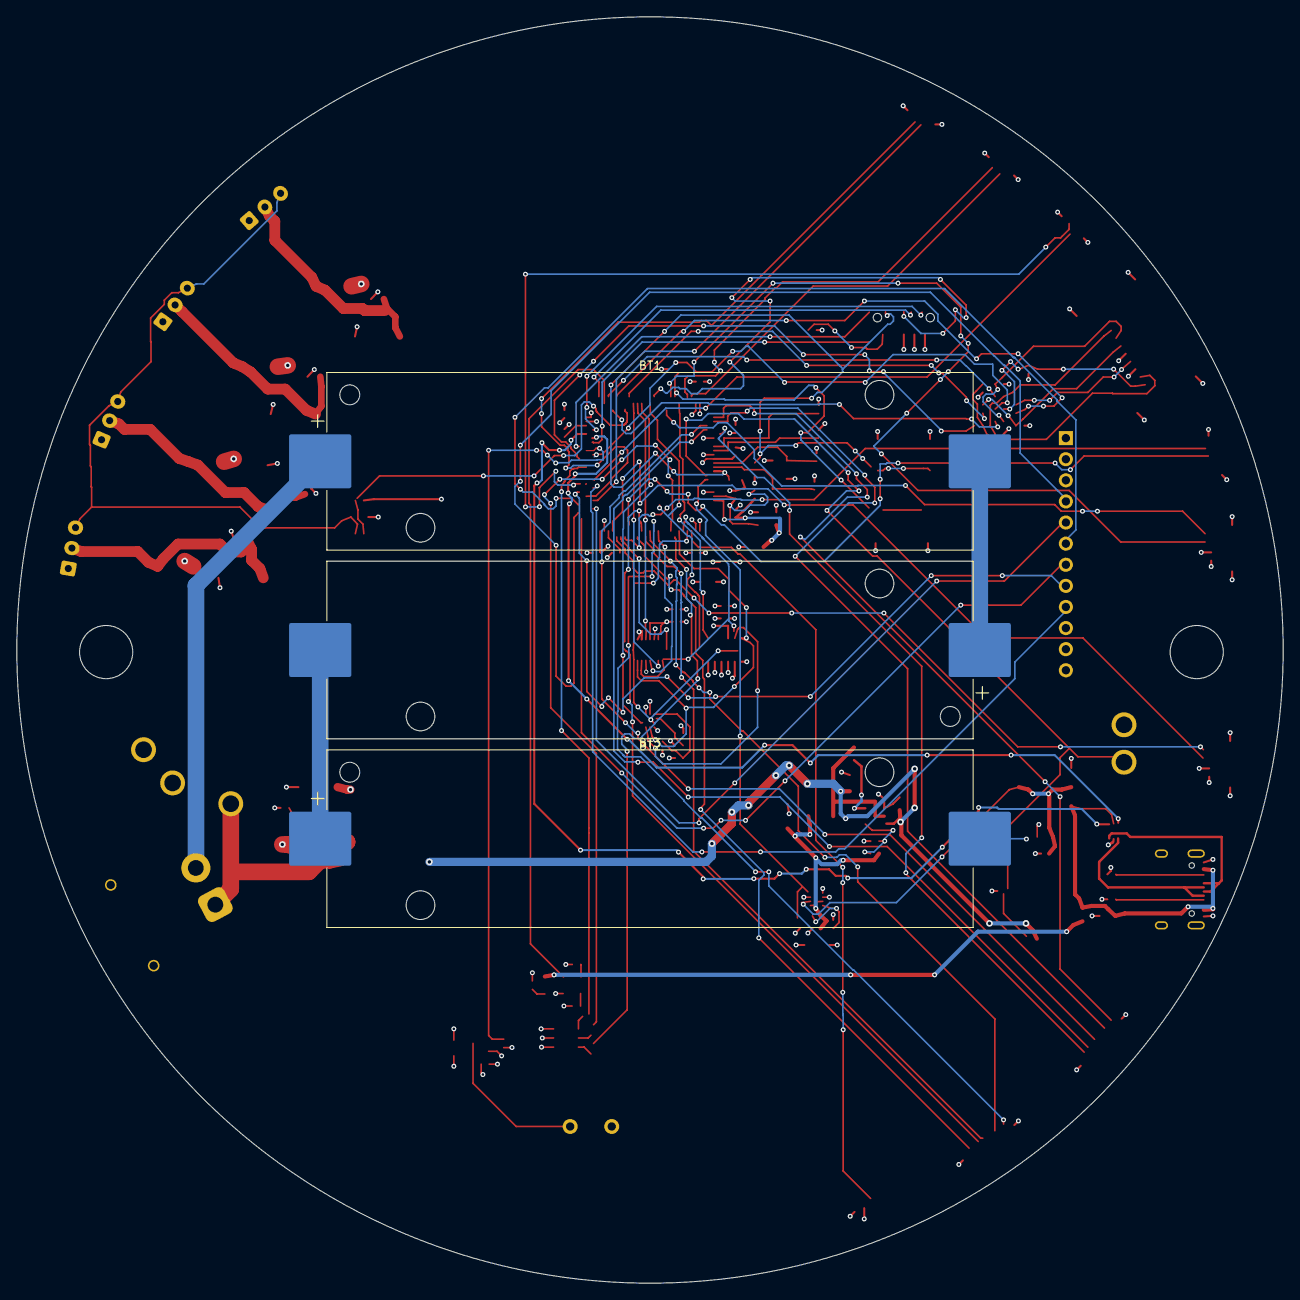
[picture p11: board aerolotl_ab.kicad_pcb from below]

Board: 4 copper layers, 152.4 x 152.4 mm, 136 parts (3 on the bottom side), 113 nets.
