stanford-ssi/Aerolotl_AB/(commit log)

2026-10-30 new base
    [aerolotl_ab.kicad_pcb, aerolotl_ab.kicad_sch, airlift.kicad_sch, external.kicad_sch, indicators.kicad_sch, mcu.kicad_sch, power.kicad_sch, sd.kicad_sch]
2026-10-31 updated routing and removed extra sensors
    [aerolotl_ab.kicad_pcb]
2026-11-02 routing: connect USB_D-, SERVO_UART, T_NRST, INT_BMP and PE6; 4 left on U1 bottom row
    Schematic unchanged from 4206fce. 124 -> 4 unconnected, DRC copper
    findings same as 4206fce. Notes in CHANGES.md.
    [aerolotl_ab.kicad_pcb]
2026-11-02 routing: SPI4.SCK/MISO connected, USB_D- follows D+; 3 left
    124 -> 3 unconnected (INT_BMP, PE11, I2C2.SCL). No new DRC findings;
    schematic unchanged from 4206fce. Notes in CHANGES.md.
    [aerolotl_ab.kicad_pcb]
2026-11-02 routing: PE11, I2C2.SCL and SPI4.MISO connected; 2 left
    124 -> 2 unconnected (SPI4.SCK, INT_BMP). No new DRC findings;
    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
    [aerolotl_ab.kicad_pcb]
